inconspicuous-username/Glitchifier9000/README.md

# Riscufefe \#5 badge repo

Some howto’s below.

# The GLITCHIFIER9000 in a nutshell

<figure>
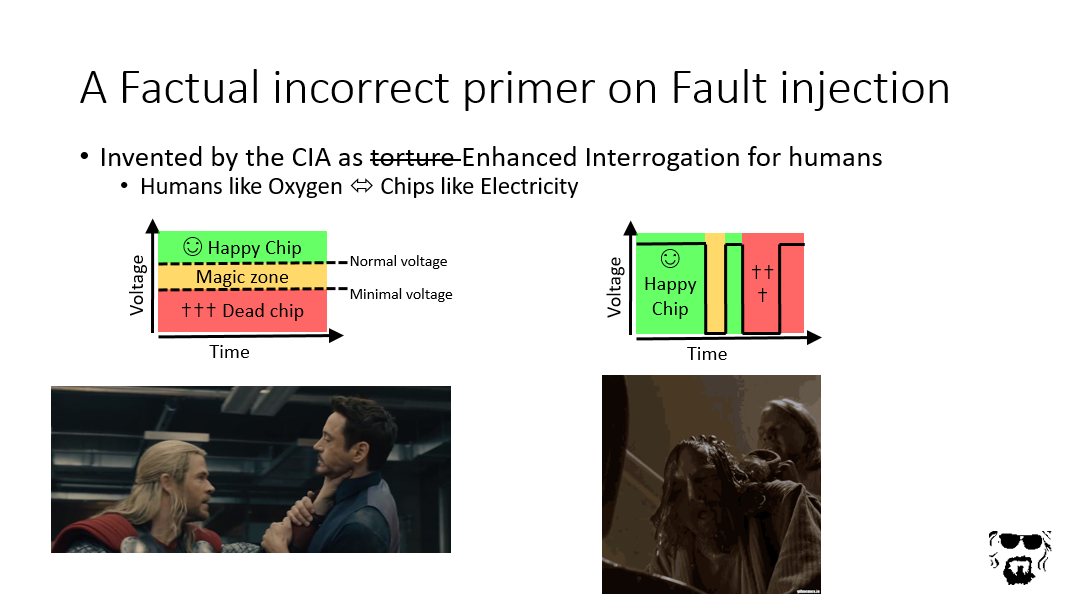
[picture p1: figs/g9k1.png]
Figure 1: What is voltage glitching?

<figcaption aria-hidden="true">Figure 1: What is voltage
glitching?</figcaption>
</figure>

<figure>
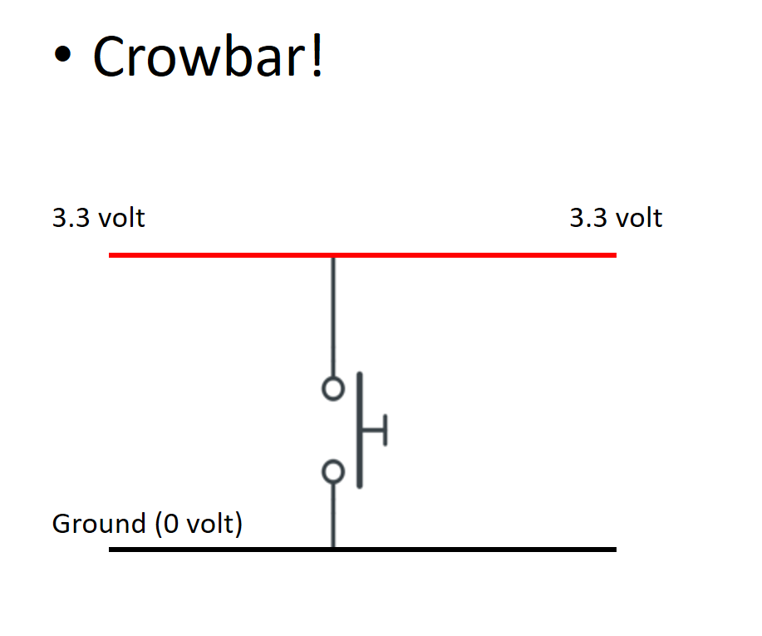
[picture p2: figs/g9k2.png]
Figure 2: Normal operation

<figcaption aria-hidden="true">Figure 2: Normal operation</figcaption>
</figure>

<figure>
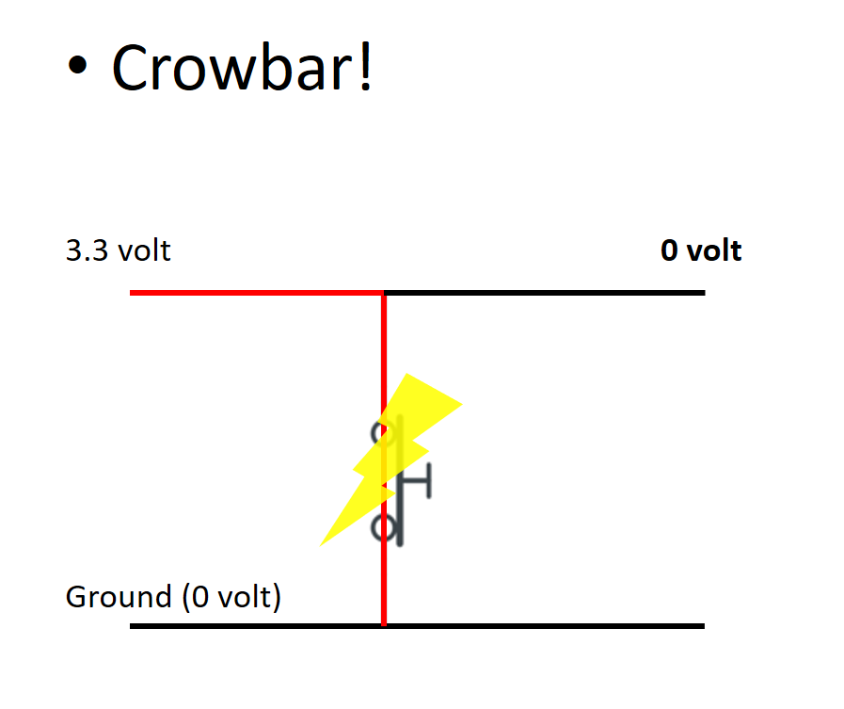
[picture p3: figs/g9k3.png]
Figure 3: While glitching

<figcaption aria-hidden="true">Figure 3: While glitching</figcaption>
</figure>

Check out the schematics [in this
repo](https://github.com/inconspicuous-username/Glitchifier9000/blob/main/hardware/pdf/Glitchifier9000-sch.pdf)
for more information!

NOTE: The trigger input is currently set to the button for demo
purposes, the use a different pin you have to modify [this
line](https://github.com/inconspicuous-username/Glitchifier9000/blob/main/firmware/upython/badge/glitchifier9000.py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).

# Hardware DIY instructions

## Minimal badge functionality

To get minimal badge functionality:

1.  Solder C3, C4

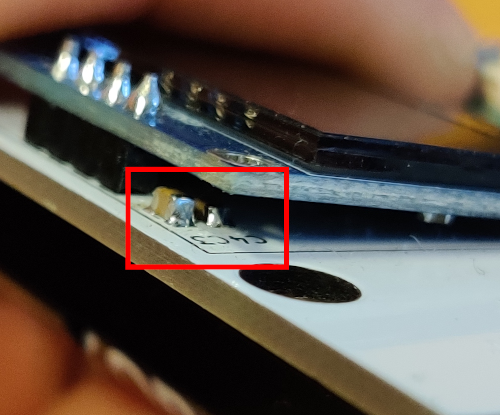
[picture p4: figs/c3c4.png]


2.  To protect your PICO from having battery and USB power at the same
    time, solder Q1:

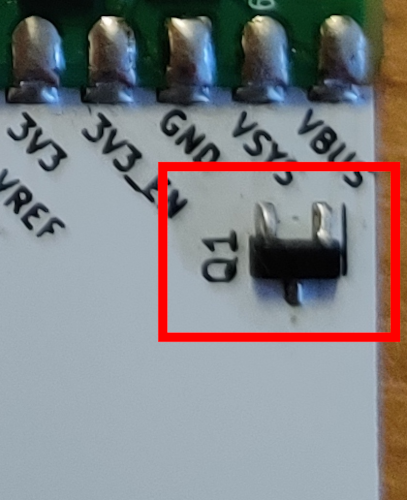
[picture p5: figs/q1.png]


3.  To be able to switch off the batteries, solder SW1:

<div layout-valign="bottom" fig-align="center">

<table>
<colgroup>
<col style="width: 50%" />
<col style="width: 50%" />
</colgroup>
<tbody>
<tr class="odd">
<td style="text-align: center;"><div width="50.0%"
data-layout-align="center">
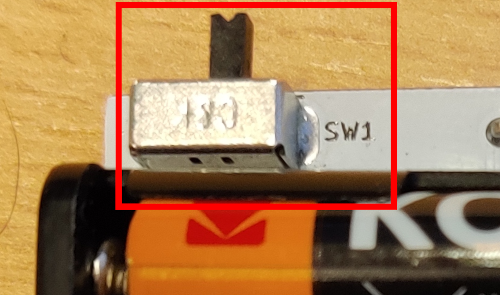
[picture p6: figs/sw2-1.png]

</div></td>
<td style="text-align: center;"><div width="50.0%"
data-layout-align="center">
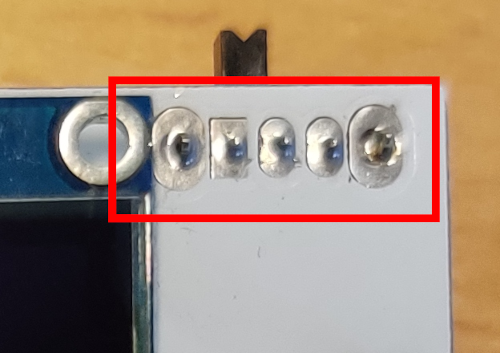
[picture p7: figs/sw2-2.png]

</div></td>
</tr>
</tbody>
</table>

</div>

4.  Attach the screen to the front:

<div layout-valign="bottom" fig-align="center">

<table>
<colgroup>
<col style="width: 50%" />
<col style="width: 50%" />
</colgroup>
<tbody>
<tr class="odd">
<td style="text-align: center;"><div width="50.0%"
data-layout-align="center">
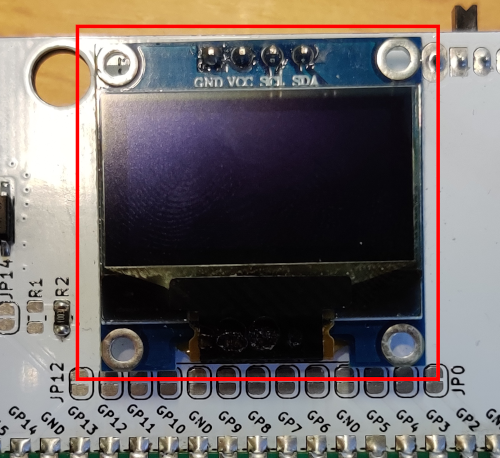
[picture p8: figs/screen1.png]

</div></td>
<td style="text-align: center;"><div width="50.0%"
data-layout-align="center">
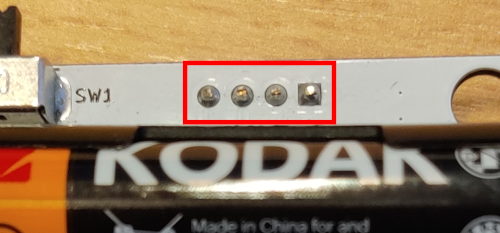
[picture p9: figs/screen2.png]

</div></td>
</tr>
</tbody>
</table>

</div>

5.  Attach the AAA battery holder to the back:

<div layout-valign="bottom" fig-align="center">

<table>
<colgroup>
<col style="width: 50%" />
<col style="width: 50%" />
</colgroup>
<tbody>
<tr class="odd">
<td style="text-align: center;"><div width="50.0%"
data-layout-align="center">
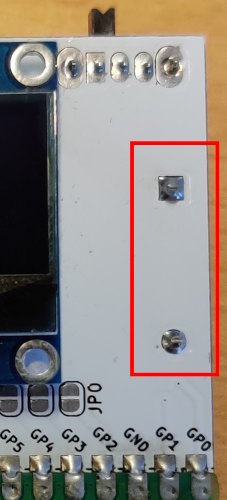
[picture p10: figs/battery1.png]

</div></td>
<td style="text-align: center;"><div width="50.0%"
data-layout-align="center">
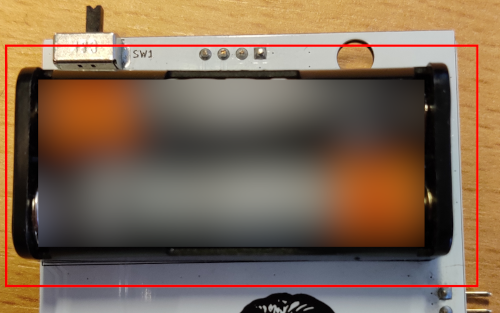
[picture p11: figs/battery2.png]

</div></td>
</tr>
</tbody>
</table>

</div>

6.  Insert 2xAAA batteries:

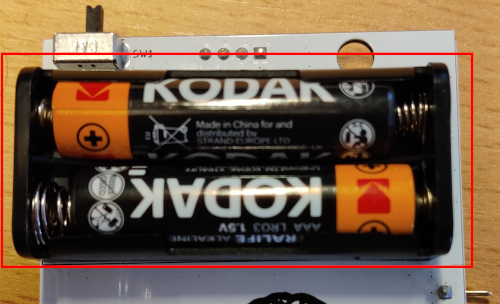
[picture p12: figs/battery3.png]


You should now be able to see stuff on the screen, and you can interact
over USB / serial.

## Button controls

To control the badge with the button:

1.  Solder the 10 (3, 2, 3, 2) points of the button at SW1:

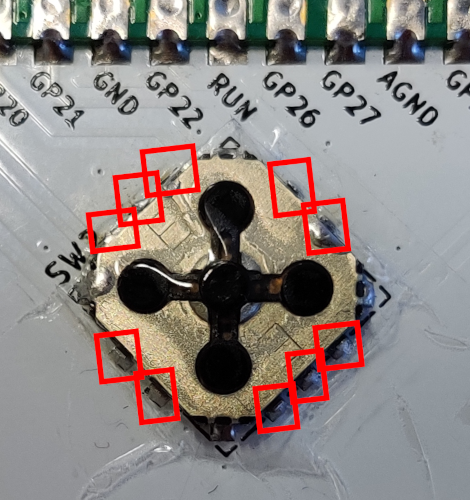
[picture p13: figs/sw1.png]


You should now be able to use the botton.

## GLITCHIFIER9000

To add GLITCHIFIER9000 functionality:

1.  Solder R2

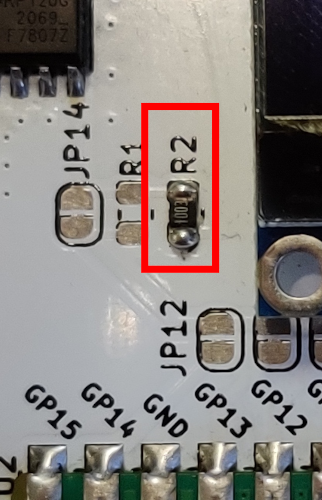
[picture p14: figs/r2.png]


2.  Solder unlabeled SOT8 MOSFET:

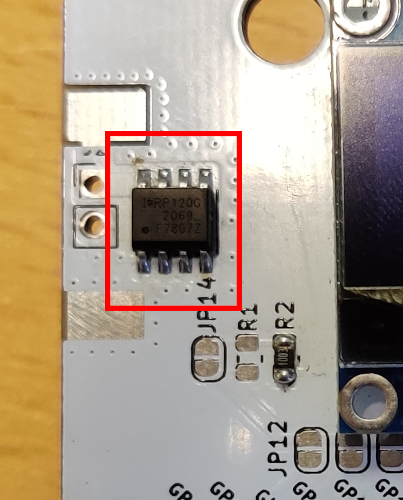
[picture p15: figs/sot8.png]


Ready to glitch!

# Talk to the badge over USB

1.  Plug in micro-usb cable.

Ready to talk!

## On Windows

1.  Install a program to talk serial, like
    [putty](https://www.chiark.greenend.org.uk/~sgtatham/putty/latest.html)

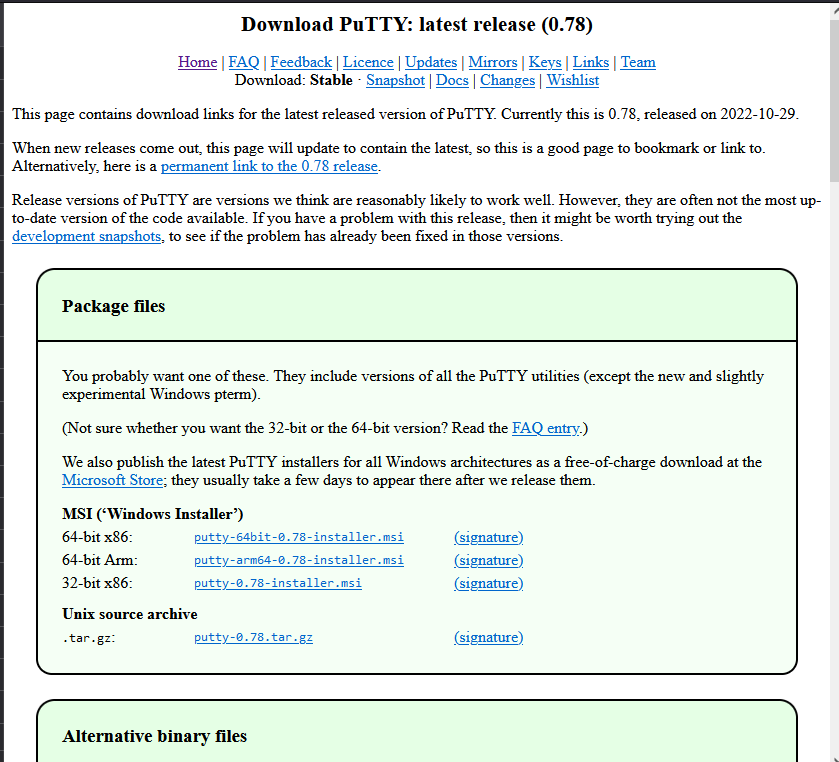
[picture p16: figs/putty1.png]


2.  Find the COM port that pops up when you plug in the USB cable in
    device manager

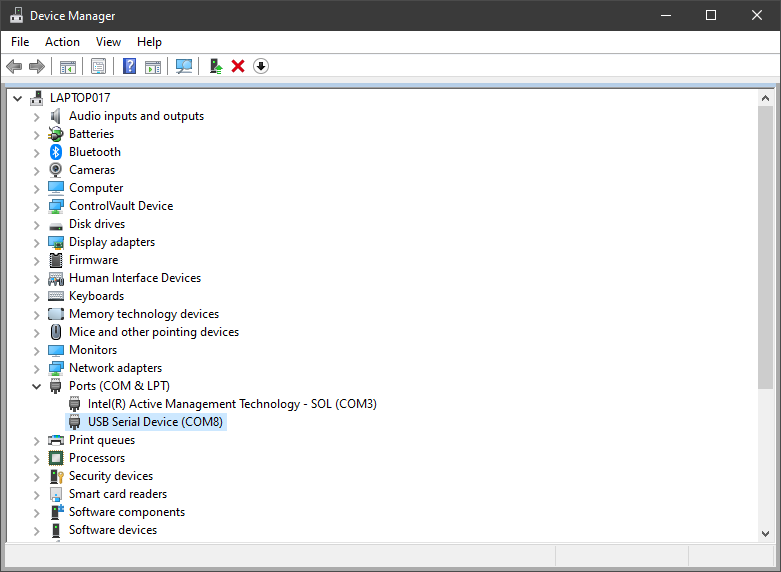
[picture p17: figs/putty2.png]


3.  Set up that COM port with speed 115200

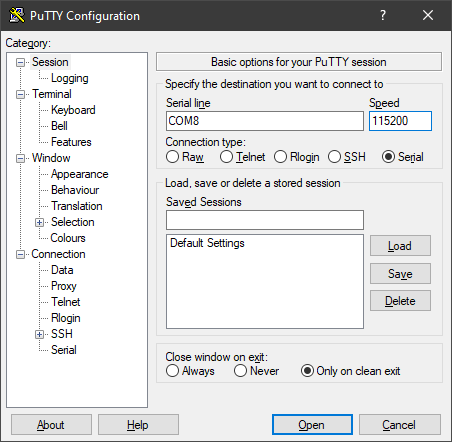
[picture p18: figs/putty3.png]


4.  Type some buttons, see what happens (also try CTRL+C and CTRL+D)

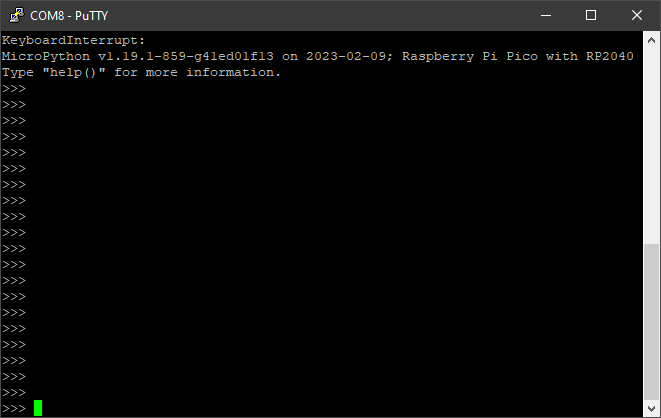
[picture p19: figs/putty4.png]


Ready to talk!

## On Linux

1.  You probably know yourself

# Set up badge firmware on a plain Raspberry Pi Pico

Set up PICO for badge

1.  Set up micropython firmware

    - Boot RPI into bootloader mode (hold BOOTSEL button and plug in
      USB)
    - Copy micropython `uf2` file to storage device (download yourself
      or located in `firmware/upython/rp2-firmware/rp2-pico-latest.uf2`)

2.  Copy firmware folder to device, for example with
    [`mpytool`](https://github.com/pavelrevak/mpytool)

    - `mpytool -p SERIALPORT put firmware/upython/badge/`

To do stuff over serial, connect with `SERIALPORT`, baudrate 115200.

# Misc

To build this document in to various formats:

    quarto render README.qmd --to pdf && \
    quarto render README.qmd --to html && \
    quarto render README.qmd --to docx && \
    quarto render README.qmd --to gfm
