inconspicuous-username/Glitchifier9000/hardware/README.md

# Glitchifier9000

pico: https://www.kiwi-electronics.com/en/raspberry-pi-pico-368/raspberry-pi-pico-10494

AAA holder? 
- https://www.digikey.nl/nl/products/detail/keystone-electronics/2468/303817
- cheaper: https://nl.mouser.com/ProductDetail/Keystone-Electronics/2468?qs=3CbvriavsLAoISGi3MywrQ%3D%3D

mosfet to switch between battery and usb
- https://nl.mouser.com/ProductDetail/Diodes-Incorporated/DMG2305UX-7?qs=L1DZKBg7t5F%2FNBHrjfxC%252Bg%3D%3D
    - https://www.diodes.com/assets/Datasheets/DMG2305UX.pdf
    
battery connector power switch
- https://nl.mouser.com/ProductDetail/CK/OS102011MA1QN1?qs=WtljUlYws5R6MUgHcLkz4w%3D%3D

cheaper and bigger for multiples of 25
- https://www.az-delivery.de/en/products/0-96zolldisplay?variant=39457349828704

## dont

charger: https://docs.sunfounder.com/projects/kepler-kit/en/latest/component/component_lipo_charger.html
