inconspicuous-username/Glitchifier9000/hardware/Kicad/Glitchifier9000/Glitchifier9000.csv

# | Reference | Qty | Value | Footprint | DNP | Shop | Price | notes | Link
1 | BT1 | 1 | Battery | Battery:BatteryHolder_Keystone_2468_2xAAA |  | mouser | 0.84 |  | https://nl.mouser.com/ProductDetail/Keystone-Electronics/2468?qs=3CbvriavsLAoISGi3MywrQ%3D%3D
2 | C3 | 1 | 10uF | Capacitor_SMD:C_0805_2012Metric |  |  | 0.03 | 100 instead of 50 | https://nl.mouser.com/ProductDetail/Samsung-Electro-Mechanics/CL21A106MQFNNNE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
3 | C4 | 1 | 0.1uF |  |  |  | 0.02 | 100 instead of 50 | https://nl.mouser.com/ProductDetail/Samsung-Electro-Mechanics/CL21B104KBCNNNL?qs=yOVawPpwOwnHyMkbG7W9YQ%3D%3D
4 | J1 | 1 | Conn_01x04 | Oled_I2C_Display:128x64 |  | azdelivery | 3.19 | price for multiples of 25 | https://www.az-delivery.de/en/products/0-96zolldisplay?variant=39457349828704
5 | J2 | 1 | Conn_01x02 | Connector_PinHeader_2.54mm:PinHeader_1x02_P2.54mm_Vertical
6 | J3 | 1 | Conn_01x04 | Connector_PinHeader_2.54mm:PinHeader_1x08_P2.54mm_Vertical
7 | JP0 .. JP14 | 14 | SolderJumper_2_Bridged | Jumper:SolderJumper-2_P1.3mm_Bridged_RoundedPad1.0x1.5mm
8 | Q1 | 1 | DMG2305UX | Package_TO_SOT_SMD:SOT-23 |  | mouser | 0.167 | 100 instead of 50 | https://nl.mouser.com/ProductDetail/Diodes-Incorporated/DMG2305UX-7?qs=L1DZKBg7t5F%2FNBHrjfxC%252Bg%3D%3D
9 | R1 | 1 | R | Resistor_SMD:R_0805_2012Metric | DNP
10 | R2 | 1 | 100k | Resistor_SMD:R_0805_2012Metric |  |  | 0.002 | 5000 instead of 50 | https://nl.mouser.com/ProductDetail/Royalohm/0805W8F1003T5E?qs=e8oIoAS2J1ShnA7x9P0k6g%3D%3D
11 | SW1 | 1 | SW_SPDT | Button_Switch_THT:SW_CuK_OS102011MA1QN1_SPDT_Angled |  | mouser | 0.39 |  | https://nl.mouser.com/ProductDetail/CK/OS102011MA1QN1?qs=WtljUlYws5R6MUgHcLkz4w%3D%3D
12 | SW2 | 1 | SW_DIP_x05 | 5-way_switch:JS1300AQ_5-way_switch |  | mouser | 1.3 |  | https://nl.mouser.com/ProductDetail/E-Switch/JS1300AQ?qs=cyOInwlKnRNRSQbl9aaldA%3D%3D
13 | U1 | 1 | IRF7807z | IRF7807:IRF7808z |  | mouser | 0.73 |  | https://nl.mouser.com/ProductDetail/Infineon-Technologies/IRF7807ZTRPBF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
14 | U2 | 1 | Pico | MCU_RaspberryPi_and_Boards:RPi_Pico_SMD_TH |  | kiwi | 3.75 | Price for 10+ | https://www.kiwi-electronics.com/en/raspberry-pi-pico-368/raspberry-pi-pico-10494
 |  |  |  |  |  |  | 10.419
