inconspicuous-username/Glitchifier9000/hardware/D-pad/dpad-buttons.stl

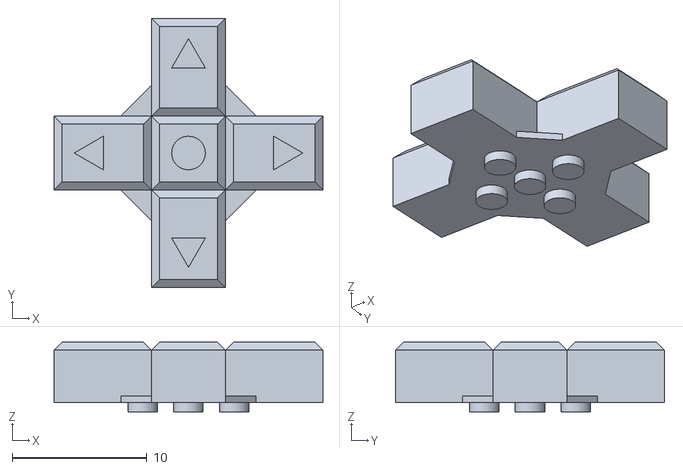
[picture p21: CAD file, 2023-03-07]
hardware/D-pad/dpad-buttons.stl
20.0 x 20.0 x 5.20
