inconspicuous-username/Glitchifier9000/hardware/D-pad/dpad-frame-high.stl

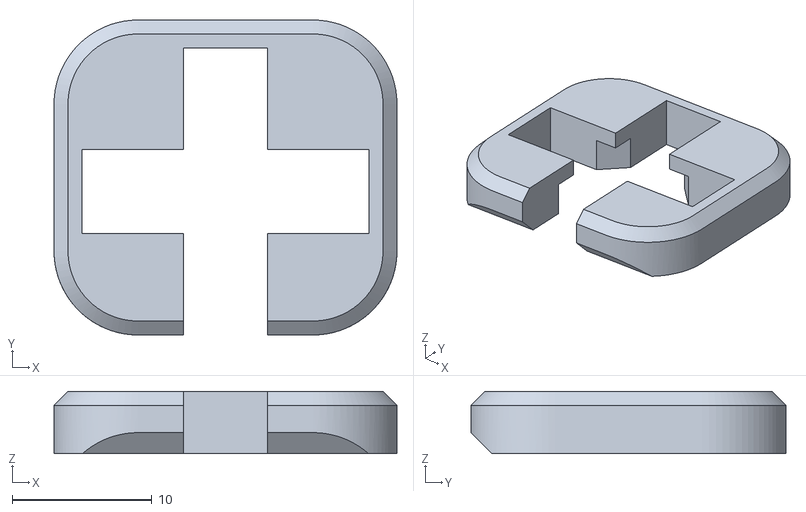
[picture p22: CAD file, 2023-03-07]
hardware/D-pad/dpad-frame-high.stl
24.5 x 22.5 x 4.45
