inconspicuous-username/Glitchifier9000/(list of files, cad)

Other CAD files:
hardware/Kicad/Glitchifier9000/KiCad-RP-Pico/SketchUp Model/Pico.skp
