inconspicuous-username/Glitchifier9000/hardware/pdf/Glitchifier9000-sch.pdf

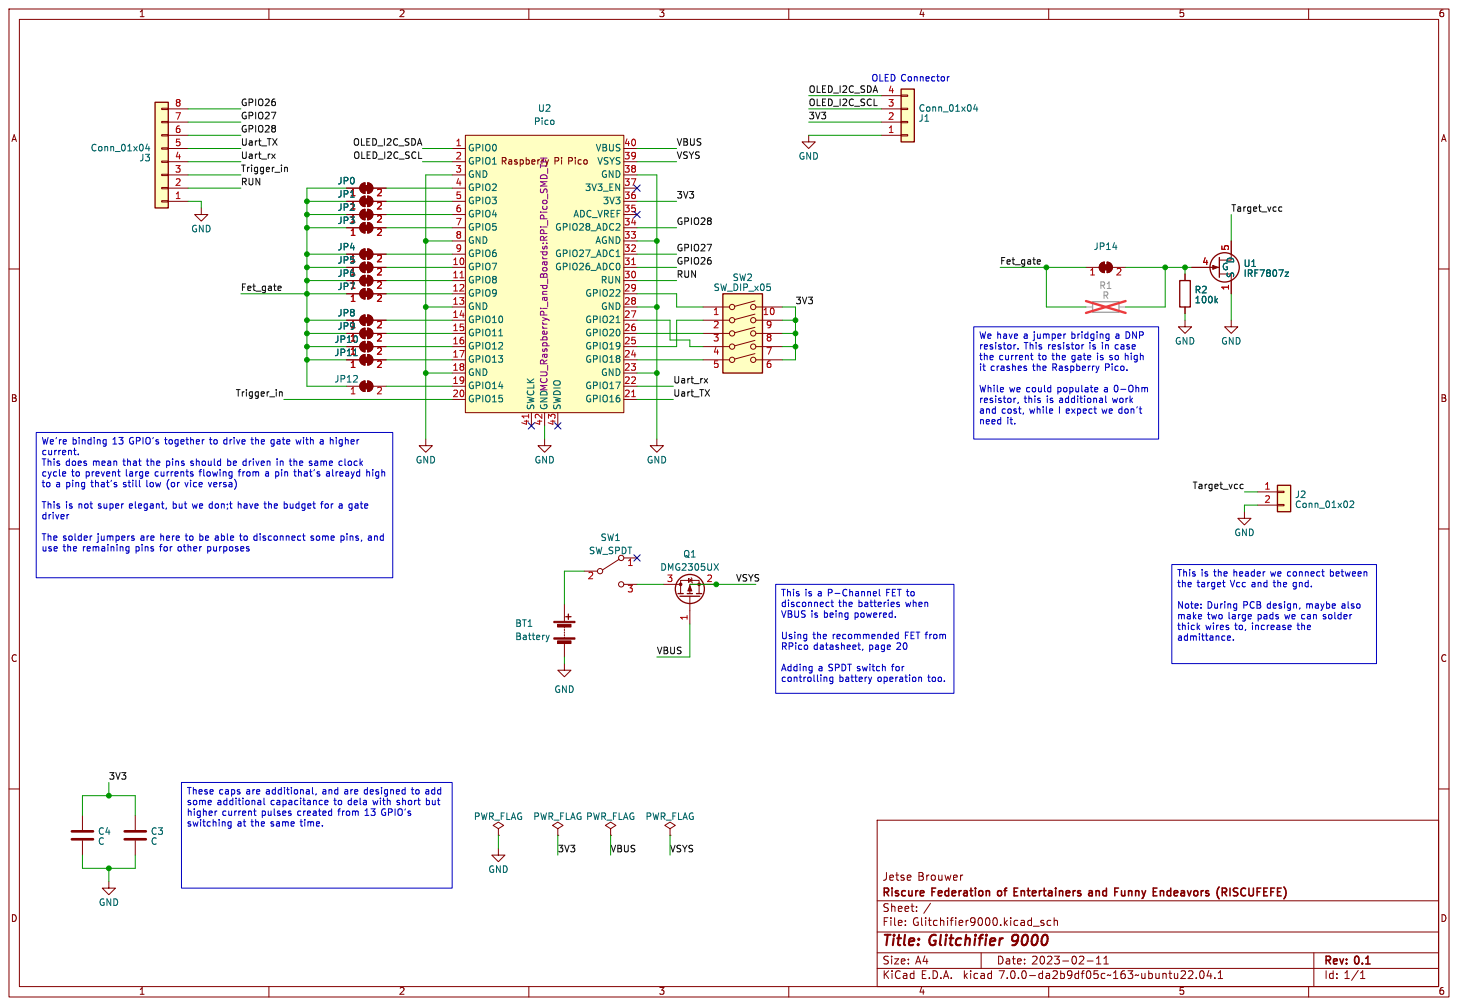
[picture p36: page 1]

resistor. This resistor is in case
the current to the gate is so high
it crashes the Raspberry Pico. While we could populate a 0-Ohm

cycle to prevent large currents flowing from a pin that's alreayd high
to a ping that's still low (or vice versa) This is not super elegant, but we don;t have the budget for a gate

the target Vcc and the gnd. Note: During PCB design, maybe also make two large pads we can solder

thick wires to, increase the
admittance.
