inconspicuous-username/Glitchifier9000/hardware/pdf/Glitchifier9000-Back.pdf

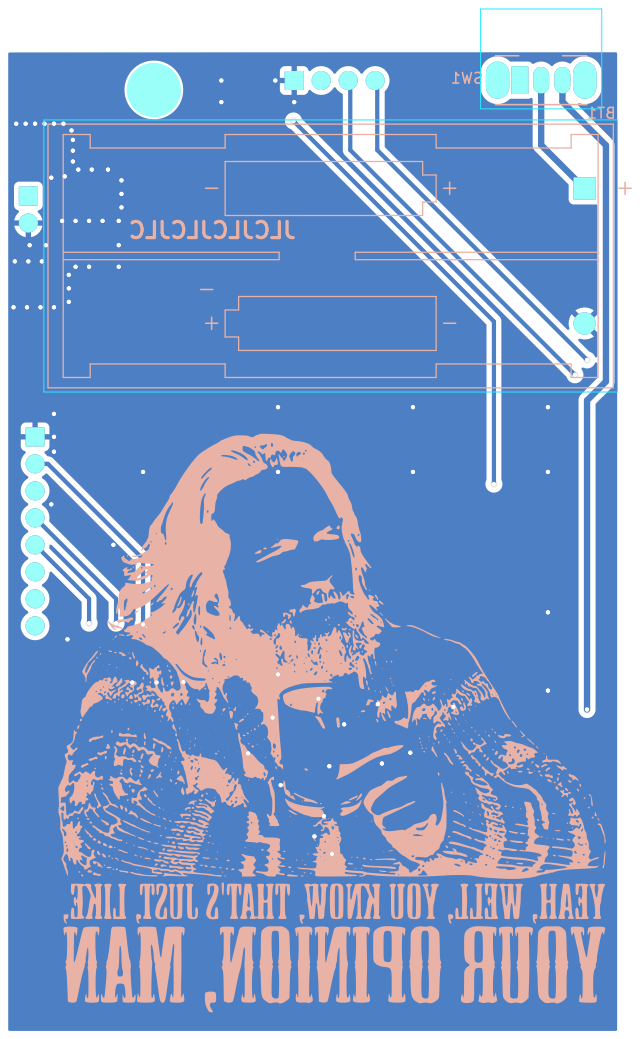
[picture p37: page 1]
