inconspicuous-username/Glitchifier9000/hardware/pdf/Glitchifier9000-Front.pdf

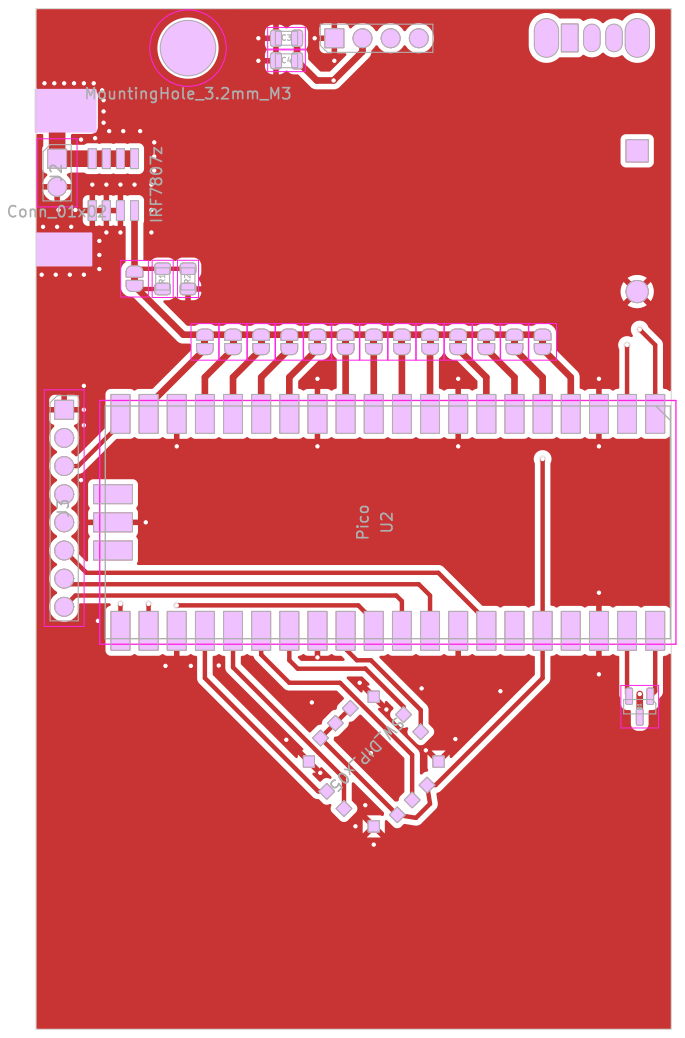
[picture p38: page 1]
