inconspicuous-username/Glitchifier9000/hardware/Simulations/Frontend.asc

R1: res; 10
R2: res; 3.3
U1: irf7807zpbf
V1: voltage; PULSE(0 3.3 0.01u 0 0 0.2u 1u)
V2: voltage; 3.3
Named nets: 0
.tran 1us
