inconspicuous-username/Glitchifier9000/(commit log)

2023-02-11 Added initial files
    [Glitchifier9000.kicad_pcb, Glitchifier9000.kicad_sch]
2023-02-11 Re-added all the file, but now not as a repo.
    [Pico.skp, Test.kicad_pcb, Test.kicad_sch]
2023-02-14 added gitignore for kicad
2023-02-14 Added all basic components to schematic
    [Glitchifier9000.kicad_pcb, Glitchifier9000.kicad_sch]
2023-02-15 write to framebuf directly
2023-02-15 Move all hardware files to own folder
    [Glitchifier9000.kicad_pcb, Glitchifier9000.kicad_sch, Pico.skp, Test.kicad_pcb, Test.kicad_sch]
2023-02-18 Add battery holder & circuit, add footprints to all symbols Change I2C pins in schematic, remove VBUS capacitors
    [Glitchifier9000.kicad_pcb, Glitchifier9000.kicad_sch]
2023-02-18 Added connectors and other things, and fixed santi's grid mess
    [Glitchifier9000.kicad_sch, Pico.skp, Test.kicad_pcb, Test.kicad_sch]
2023-02-18 Did things
    [Glitchifier9000.kicad_pcb, Glitchifier9000.kicad_sch]
2023-02-18 Added footprints and rough pcb layout
    [Glitchifier9000.kicad_pcb, Glitchifier9000.kicad_sch]
2023-02-19 First try to PCB-ing, changes in trigger pin, I2C pins, header GPIO pins
    [Glitchifier9000.kicad_pcb, Glitchifier9000.kicad_sch]
2023-02-19 made pcb 10 cm talls for improved ergonomics
    [Glitchifier9000.kicad_pcb]
2023-02-19 Simplified button routing by swapping pin 2 and 4.
    [Glitchifier9000.kicad_pcb, Glitchifier9000.kicad_sch]
2023-02-19 Added a pulldown resistor on the gate of the glitch fet
    [Glitchifier9000.kicad_pcb, Glitchifier9000.kicad_sch]
2023-02-19 forgot to save before commiting
    [Glitchifier9000.kicad_pcb]
2023-02-19 Add The Dude drawing, remove some holes, add another hole, re-route some for better cosmetics
    [Glitchifier9000.kicad_pcb]
2023-02-19 fix 3v3 caps placement
    [Glitchifier9000.kicad_pcb]
2023-02-19 BOM with links
    [Glitchifier9000.csv]
2023-02-19 Pre-fabrication output
    [Glitchifier9000.kicad_pcb]
2023-02-19 and now for real, because I forgot to change
    [Glitchifier9000.kicad_pcb]
2023-02-19 Generated gerbers that we ordered with
    [Glitchifier9000-B_Mask.gbs, Glitchifier9000-B_Paste.gbp, Glitchifier9000-B_Silkscreen.gbo, Glitchifier9000-Back.gbl, Glitchifier9000-Edge_Cuts.gm1, Glitchifier9000-F_Mask.gts, Glitchifier9000-F_Paste.gtp, Glitchifier9000-F_Silkscreen.gto]
2023-02-19 boot on a timer for 'multithreading'
2023-02-19 add caps
    [Glitchifier9000.csv]
2023-02-19 pdf layout and schematic
2023-02-26 button interrupts, trying to tie stuff together
2023-02-27 added more tying together and glitchifier code, irqs are still weird (also in debouncer.py i dont fully understand)
    [boot.py, glitchifier9000.py, graphics.py, head.py, main.py, overclock.py]
2023-03-01 bugfixes and glitchifier animation
    [debug.py, glitchifier9000.py, main.py]
2023-03-07 gracefully handle missing screen
    [main.py]
2023-03-07 ✨ Add 3d printed D-pad
    [dpad-buttons.stl, dpad-frame-high.stl]
2023-04-27 working on a more sane glitching control firmware
    [main.py]
